alangarf/C64-Pi1541-II/C64 Pi1541-II Module SMD/C64 Pi1541-II Module.kicad_pcb

## KiCad design C64 Pi1541-II Module SMD/C64 Pi1541-II Module.kicad_pcb (2020-11-29)

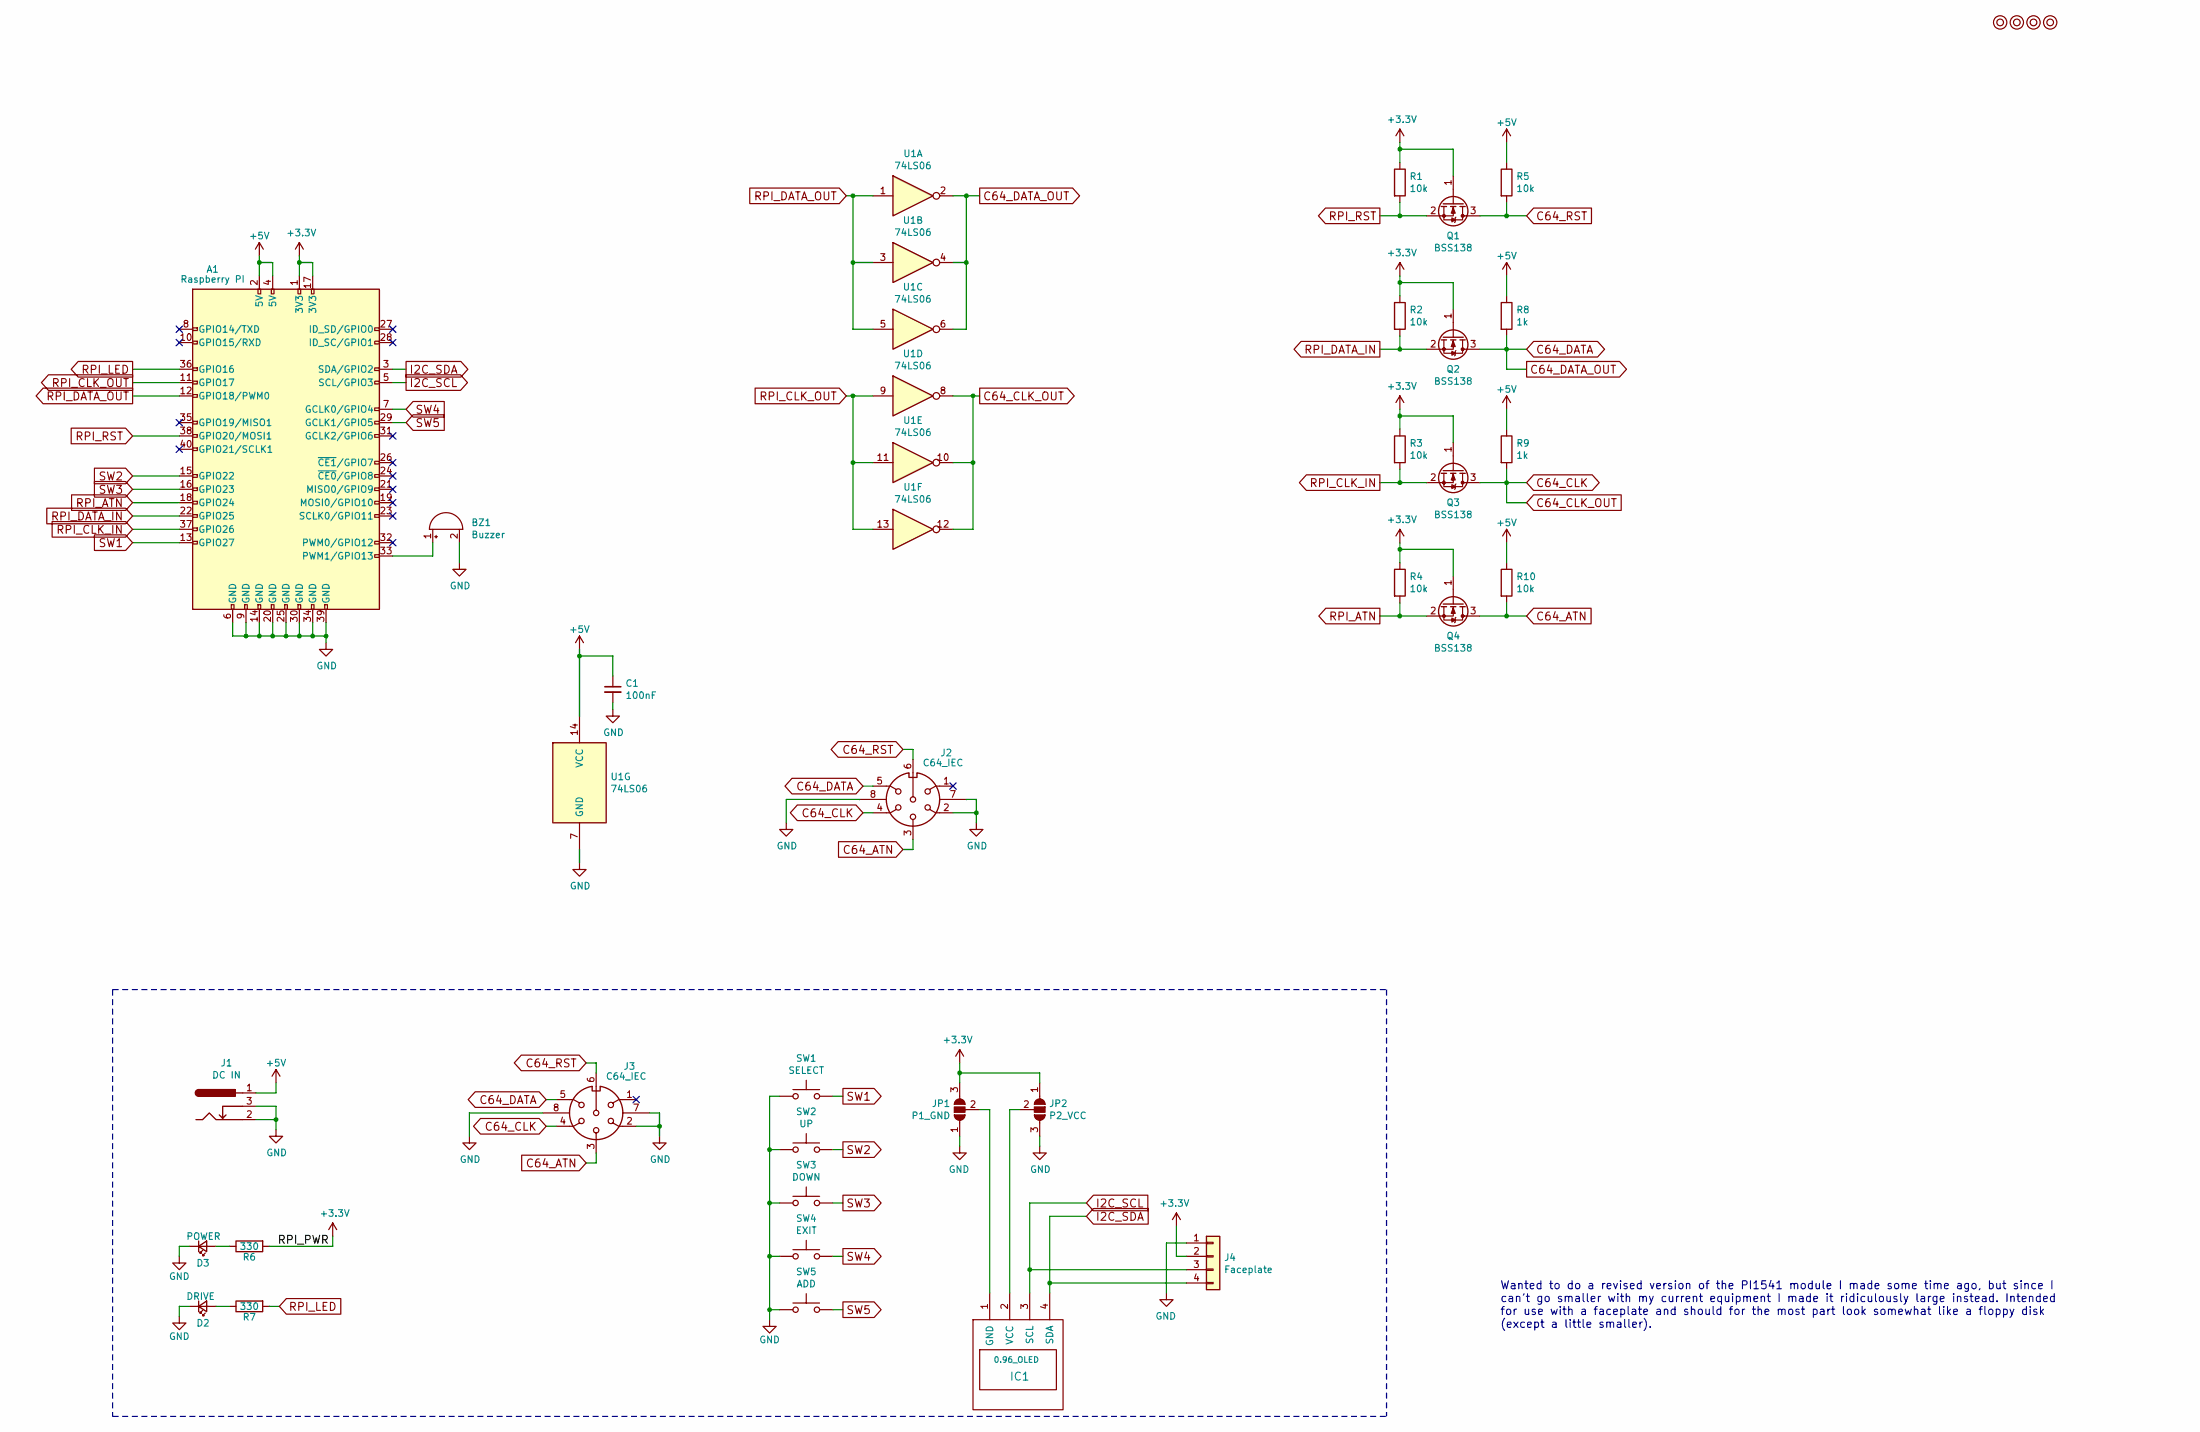
[picture p1: schematic C64 Pi1541-II Module.sch, Pi1541-II Module]

Parts:
A1: Raspberry PI; Raspberry_Pi_3B_Socketed_THT_FaceDown_MountingHoles
BZ1: Buzzer; Buzzer_12x9.5RM7.6
C1: 100nF; C_0805_2012Metric_Pad1.18x1.45mm_HandSolder
D2: DRIVE; LED_0805_2012Metric_Pad1.15x1.40mm_HandSolder
D3: POWER; LED_0805_2012Metric_Pad1.15x1.40mm_HandSolder
IC1: 0.96_OLED; 0.96_I2C_OLED
J1: DC IN; BarrelJack_Horizontal
J2, J3: C64_IEC
J4: Faceplate; PinHeader_1x04_P2.54mm_Vertical
JP1: P1_GND; OLED_SEL
JP2: P2_VCC; OLED_SEL
M1, M2, M3, M4: Mounting; M3
Q1, Q2, Q3, Q4: BSS138; SOT-23
R1, R2, R3, R4, R5, R10: 10k; R_0805_2012Metric_Pad1.20x1.40mm_HandSolder
R6, R7: 330; R_0805_2012Metric_Pad1.20x1.40mm_HandSolder
R8, R9: 1k; R_0805_2012Metric_Pad1.20x1.40mm_HandSolder
SW1: SELECT; SW_Tactile_SPST_Angled_PTS645Vx39-2LFS
SW2: UP; SW_Tactile_SPST_Angled_PTS645Vx39-2LFS
SW3: DOWN; SW_Tactile_SPST_Angled_PTS645Vx39-2LFS
SW4: EXIT; SW_Tactile_SPST_Angled_PTS645Vx39-2LFS
SW5: ADD; SW_Tactile_SPST_Angled_PTS645Vx39-2LFS
U1: 74LS06; SOIC-14_3.9x8.7mm_P1.27mm

Connections:
+3V3: A1.1 (3V3), A1.17 (3V3), J4.2, JP1.3 (B), JP2.1 (A), Q1.1 (G), Q2.1 (G), Q3.1 (G), Q4.1 (G), R1.1, R2.1, R3.1, R4.1, R6.2
+5V: A1.2 (5V), A1.4 (5V), C1.1, J1.1, R5.1, R8.1, R9.1, R10.1, U1.14 (VCC)
C64_ATN: J2.3, J3.3, Q4.3 (D), R10.2
C64_CLK: J2.4, J3.4, Q3.3 (D), R9.2, U1.8, U1.10, U1.12
C64_DATA: J2.5, J3.5, Q2.3 (D), R8.2, U1.2, U1.4, U1.6
C64_RST: J2.6, J3.6, Q1.3 (D), R5.2
GND: A1.6 (GND), A1.9 (GND), A1.14 (GND), A1.20 (GND), A1.25 (GND), A1.30 (GND), A1.34 (GND), A1.39 (GND), BZ1.2 (+), C1.2, D2.1 (K), D3.1 (K), J1.2, J1.3, J2.2, J2.7, J2.8, J3.2, J3.7, J3.8, J4.1, JP1.1 (A), JP2.3 (B), SW1.1, SW2.1, SW3.1, SW4.1, SW5.1, U1.7 (GND)
I2C_SCL: A1.5 (SCL/GPIO3), IC1.3 (SCL), J4.3
I2C_SDA: A1.3 (SDA/GPIO2), IC1.4 (SDA), J4.4
unnamed: A1.33 (PWM1/GPIO13), BZ1.1 (-)
unnamed: D2.2 (A), R7.1
unnamed: D3.2 (A), R6.1
unnamed: IC1.1 (GND), JP1.2 (C)
unnamed: IC1.2 (VCC), JP2.2 (C)
RPI_ATN: A1.18 (GPIO24), Q4.2 (S), R4.2
RPI_CLK_IN: A1.37 (GPIO26), Q3.2 (S), R3.2
RPI_CLK_OUT: A1.11 (GPIO17), U1.9, U1.11, U1.13
RPI_DATA_IN: A1.22 (GPIO25), Q2.2 (S), R2.2
RPI_DATA_OUT: A1.12 (GPIO18/PWM0), U1.1, U1.3, U1.5
RPI_LED: A1.36 (GPIO16), R7.2
RPI_RST: A1.38 (GPIO20/MOSI1), Q1.2 (S), R1.2
SW1: A1.13 (GPIO27), SW1.2
SW2: A1.15 (GPIO22), SW2.2
SW3: A1.16 (GPIO23), SW3.2
SW4: A1.7 (GCLK0/GPIO4), SW4.2
SW5: A1.29 (GCLK1/GPIO5), SW5.2

Notes on the sheet:
Wanted to do a revised version of the PI1541 module I made some time ago, but since I can't go smaller with my current equipment I made it ridiculously large instead. Intended for use with a faceplate and should for the most part look somewhat like a floppy disk (except a little smaller).

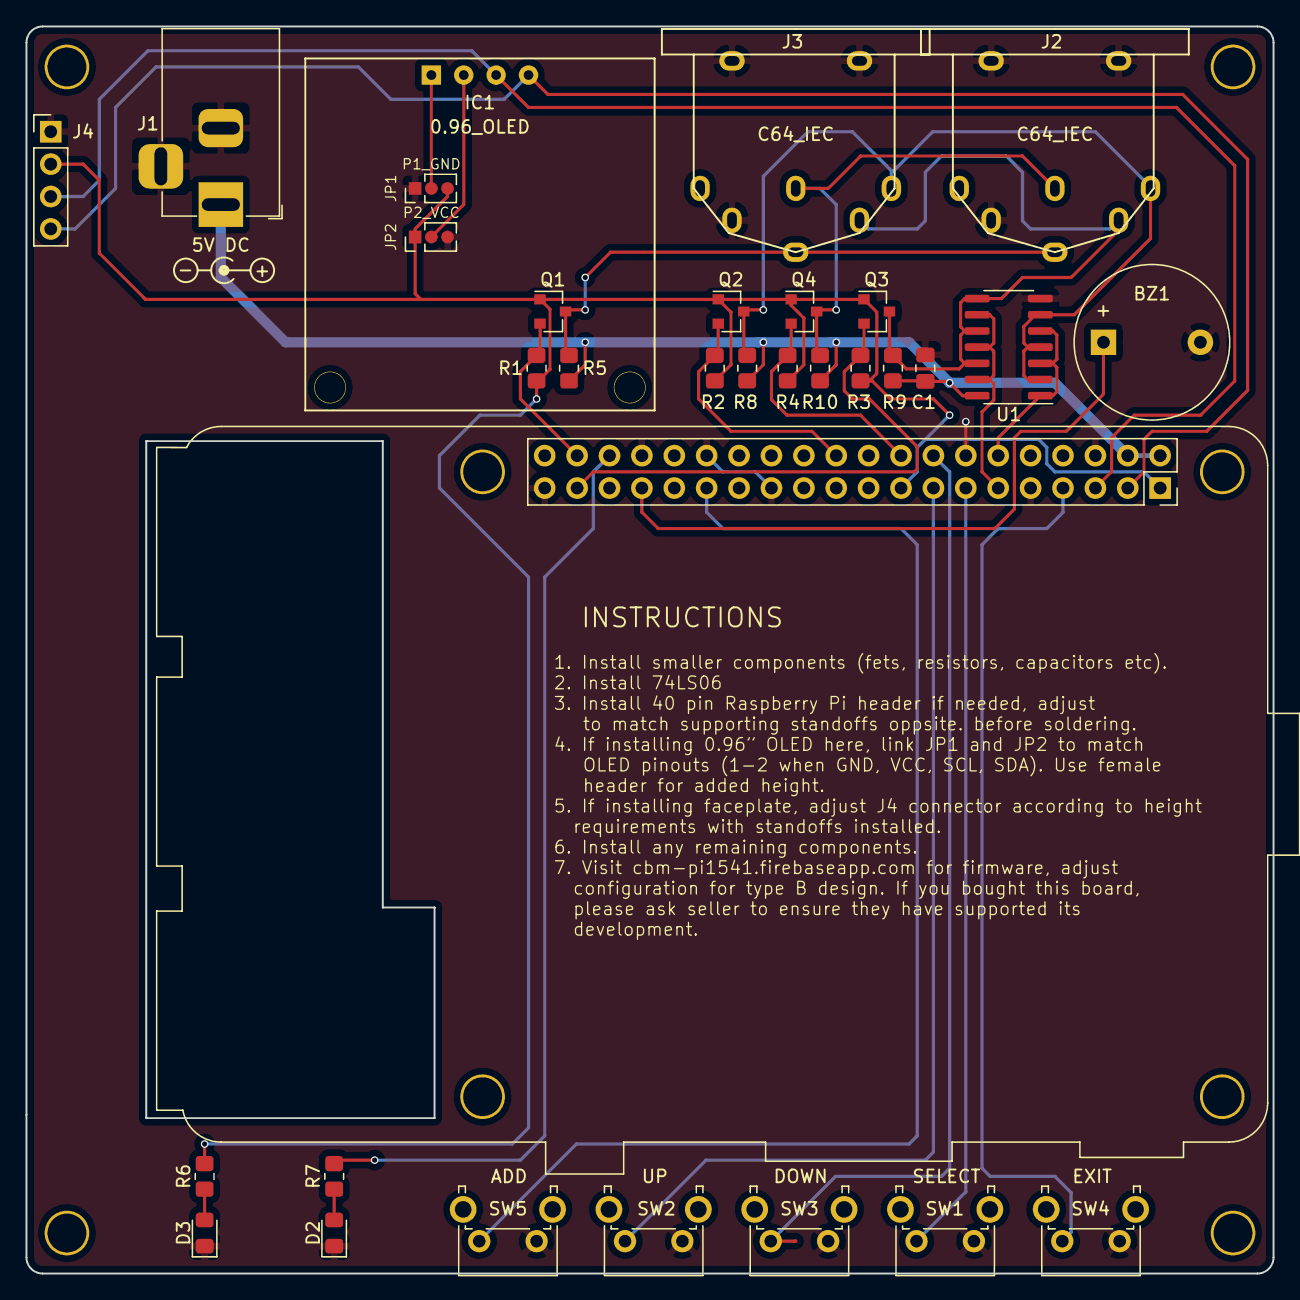
[picture p2: board C64 Pi1541-II Module.kicad_pcb from above]

Board: 2 copper layers, 97.8 x 97.8 mm, 36 parts (0 on the bottom side), 26 nets.
