alangarf/C64-Pi1541-II/C64 Pi1541-II Faceplate SMD/C64 Pi1541-II Faceplate.kicad_pcb

## KiCad design C64 Pi1541-II Faceplate SMD/C64 Pi1541-II Faceplate.kicad_pcb (2020-11-29)

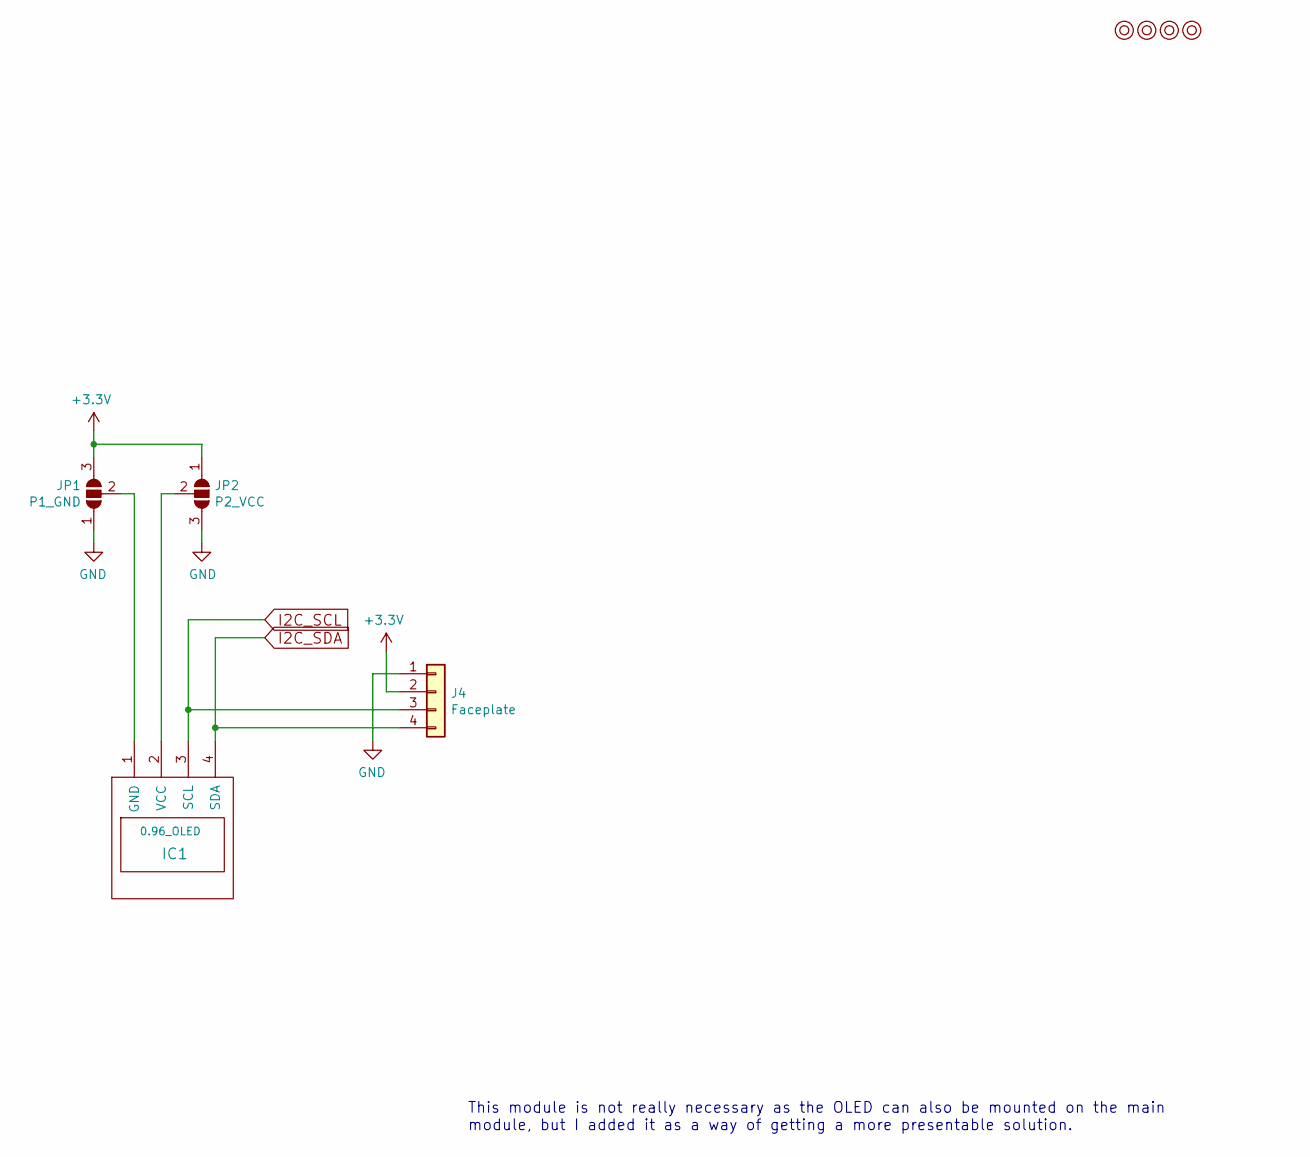
[picture p3: schematic C64 Pi1541-II Faceplate.sch, Pi1541-II Faceplate]

Parts:
IC1: 0.96_OLED; 0.96_I2C_OLED2
J4: Faceplate; Pin_Header_Straight_1x04_Pitch2.54mm
JP1: P1_GND; OLED_SEL
JP2: P2_VCC; OLED_SEL
M1, M2, M3, M4: Mounting; M3

Connections:
+3V3: J4.2, JP1.3 (B), JP2.1 (A)
GND: J4.1, JP1.1 (A), JP2.3 (B)
I2C_SCL: IC1.3 (SCL), J4.3
I2C_SDA: IC1.4 (SDA), J4.4
unnamed: IC1.1 (GND), JP1.2 (C)
unnamed: IC1.2 (VCC), JP2.2 (C)

Notes on the sheet:
This module is not really necessary as the OLED can also be mounted on the main module, but I added it as a way of getting a more presentable solution.

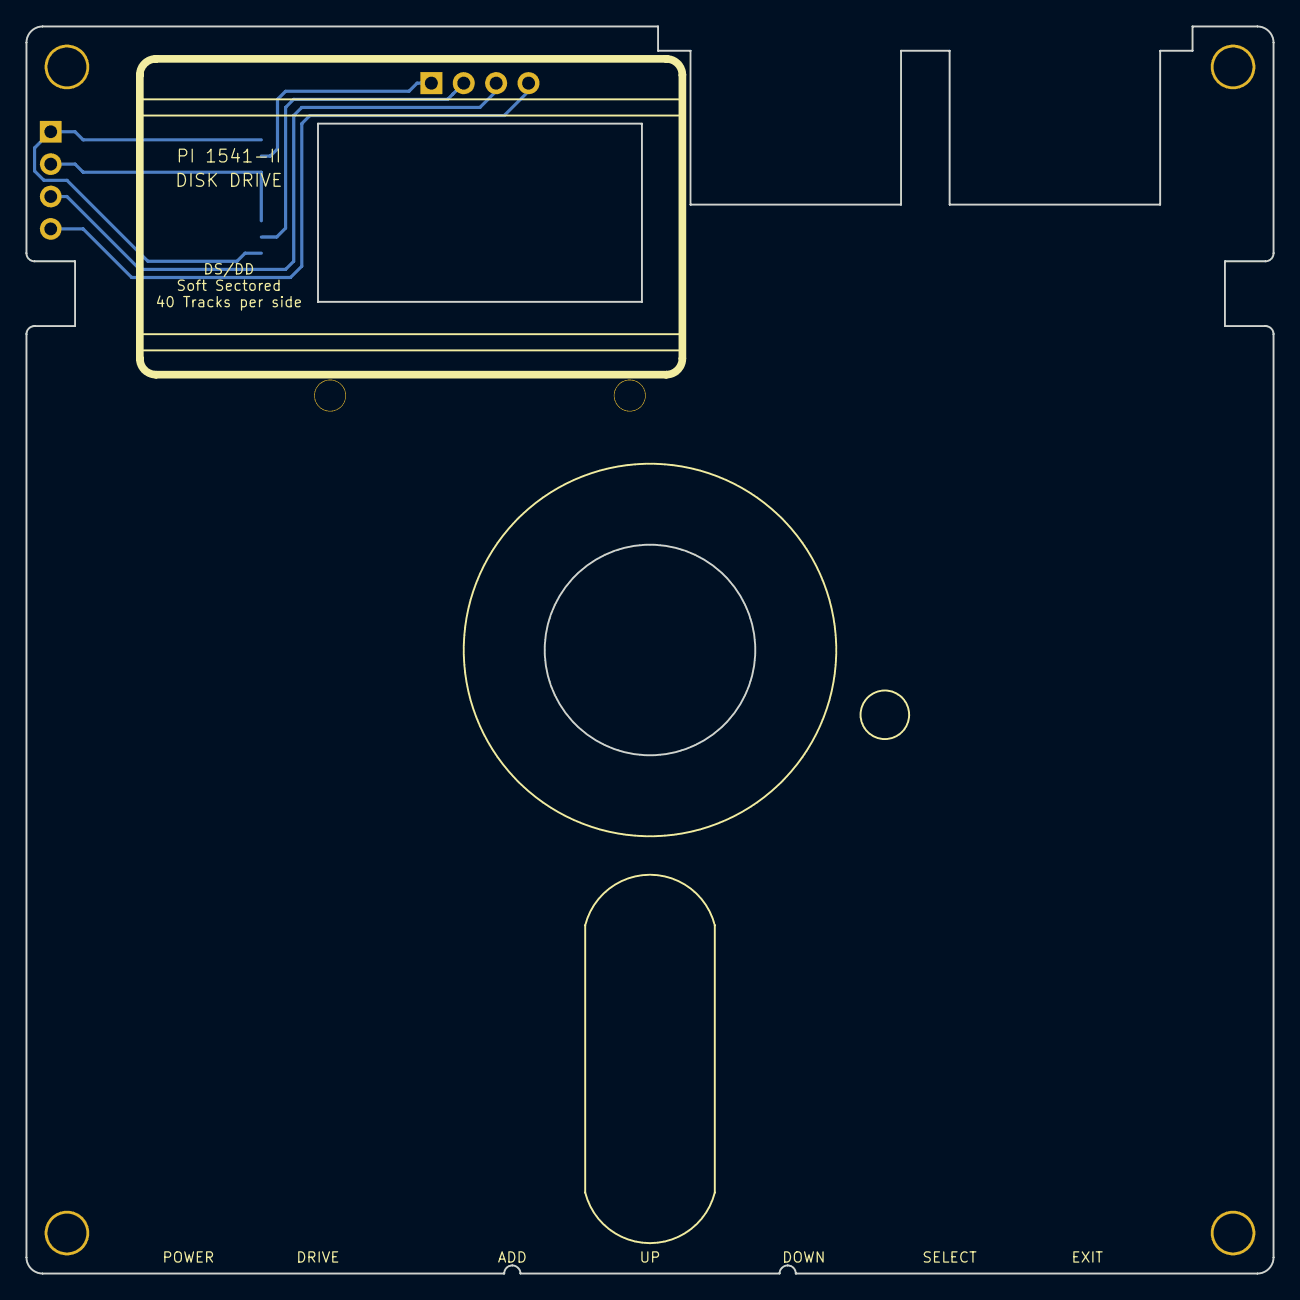
[picture p4: board C64 Pi1541-II Faceplate.kicad_pcb from above]

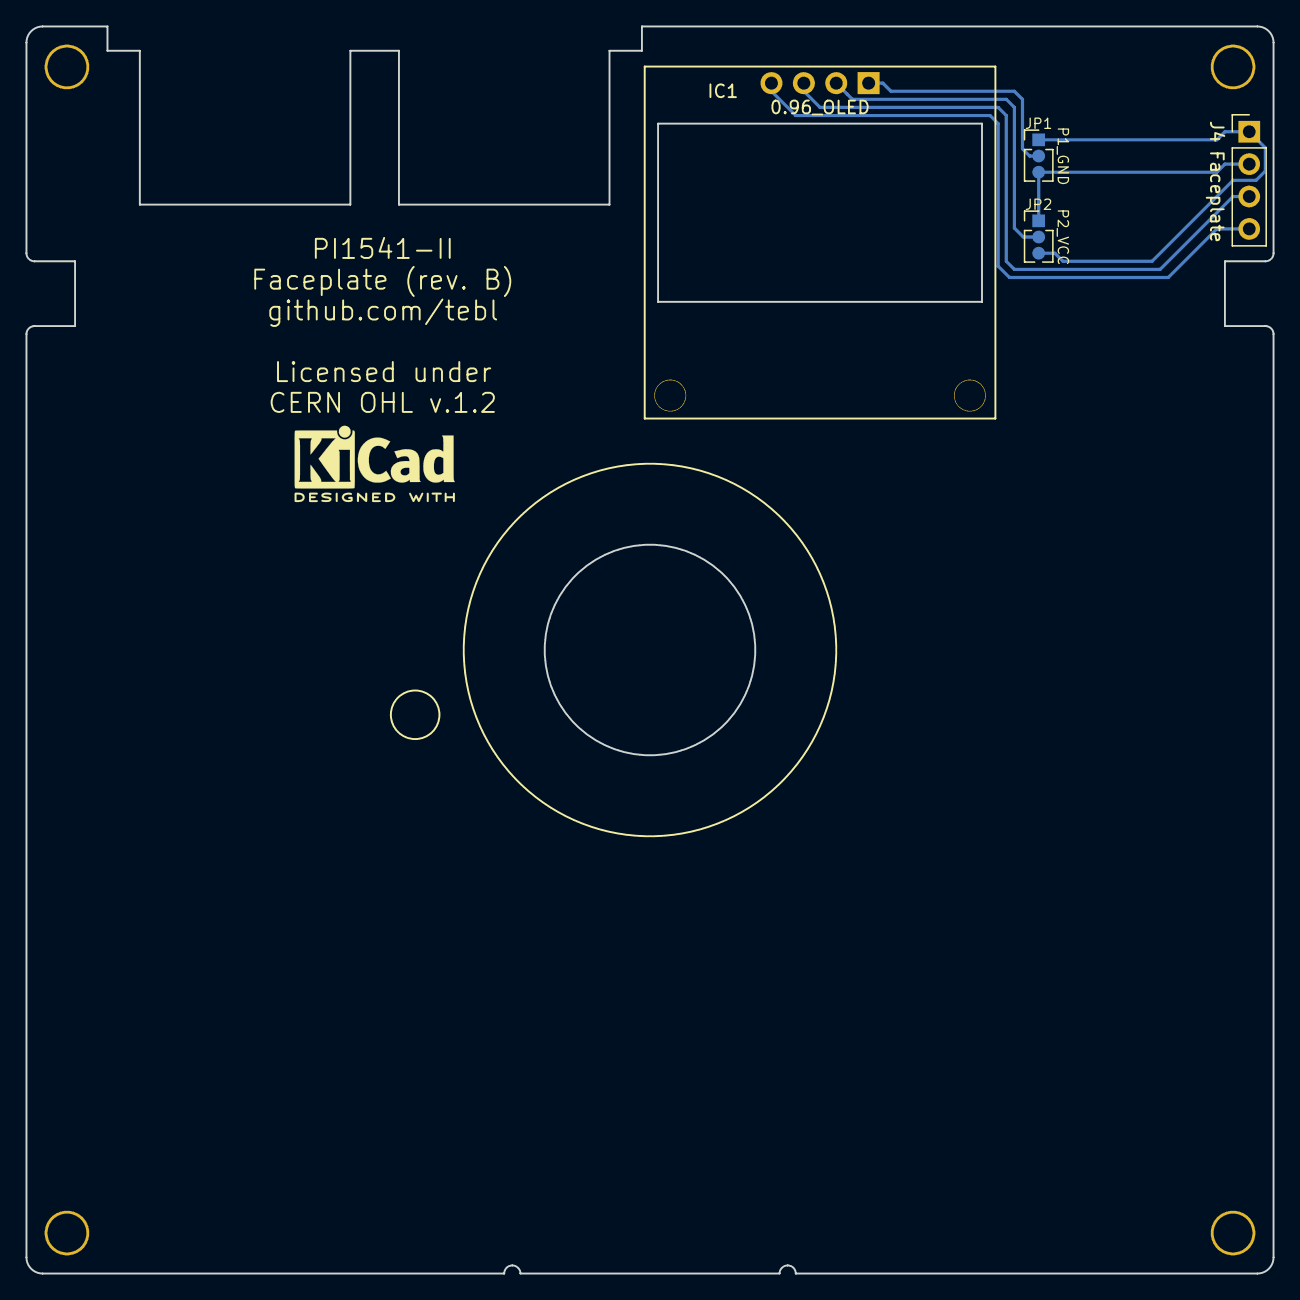
[picture p5: board C64 Pi1541-II Faceplate.kicad_pcb from below]

Board: 2 copper layers, 97.8 x 97.8 mm, 8 parts (3 on the bottom side), 6 nets.
