alangarf/C64-Pi1541-II/(notices)

Notices in the files:
C64 Pi1541-II Faceplate SMD/C64 Pi1541-II Faceplate.kicad_pcb:
Licensed under
CERN OHL v.1.2
